mkhairyx/iOS-MoonLamp/README.md

# iOS Moon Lamp
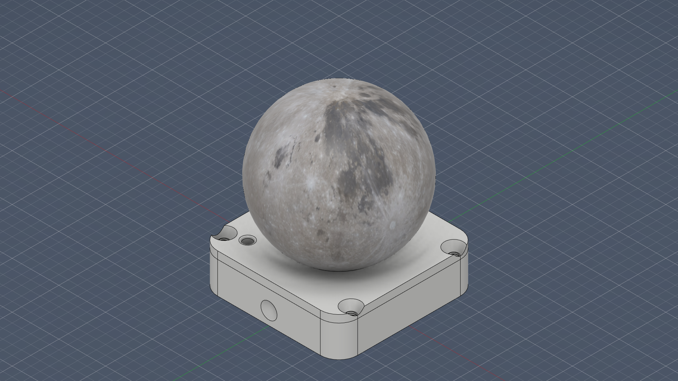
[picture p1: Media/Pictures/Fusion360/iOS_MoonLamp.png]
3D Moon Lamp


Bought a battery powered Moon lamp a few years ago, and it was cool back then but now it’s boring that I have to turn it on and off manually every night. So I removed the insides of it and made it powered with an ESP32 controlled by the iOS Home app.

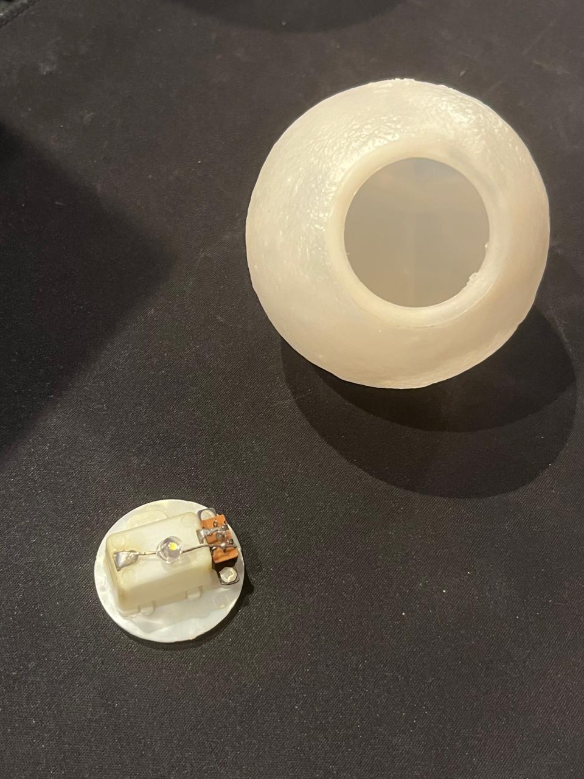
[picture p2: Media/Pictures/Camera/lampbat.jpeg]
Moon Lamp


## The Poster

High resolution poster available [here](./Media/Pictures/PSD/MoonLamp.png).

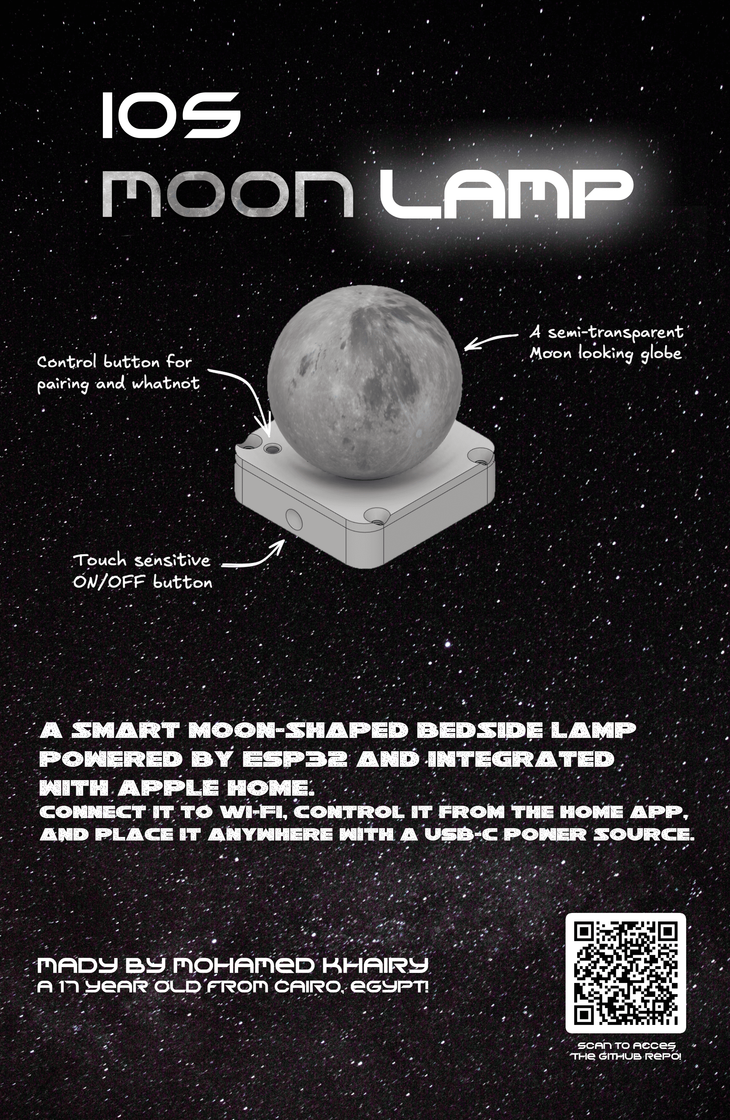
[picture p3: Media/Pictures/PSD/MoonLamp-lores.png]
Poster


## The Design

### The PCB:
Here's how the PCB looks like:
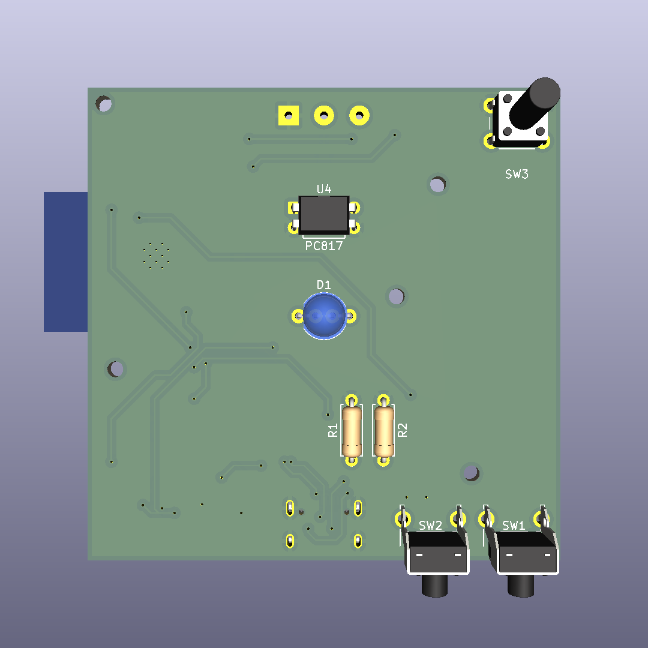
[picture p4: Media/Pictures/KiCad/3D_1-1.png]
3D PCB

And here's the gerber view for it:
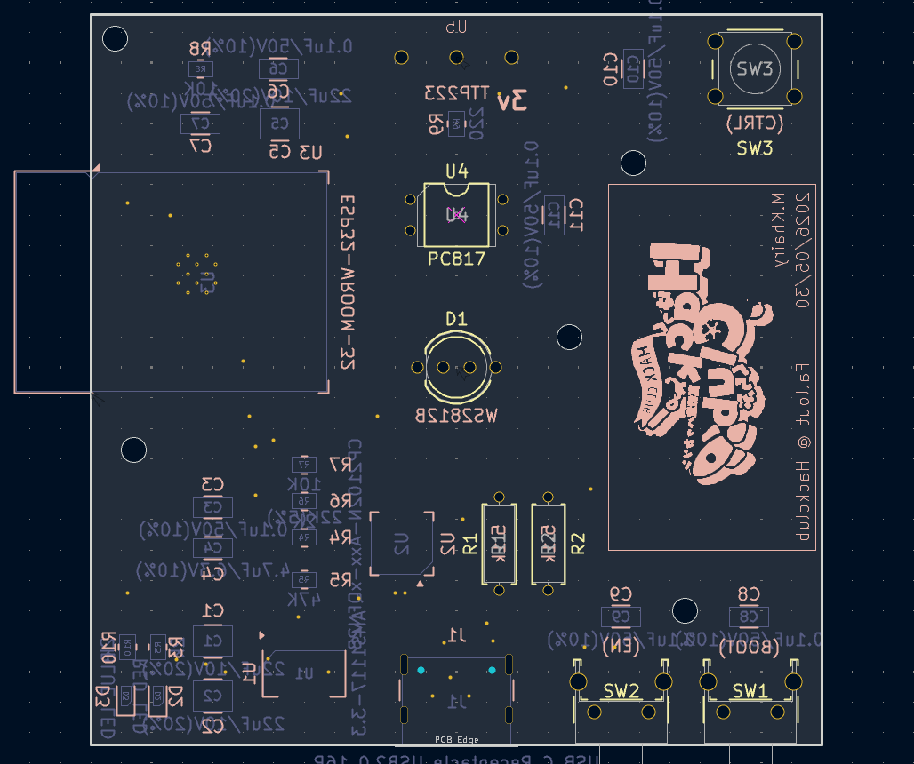
[picture p5: Media/Pictures/KiCad/PCB_Gerber.png]
KiCad PCB


### The Schematics:
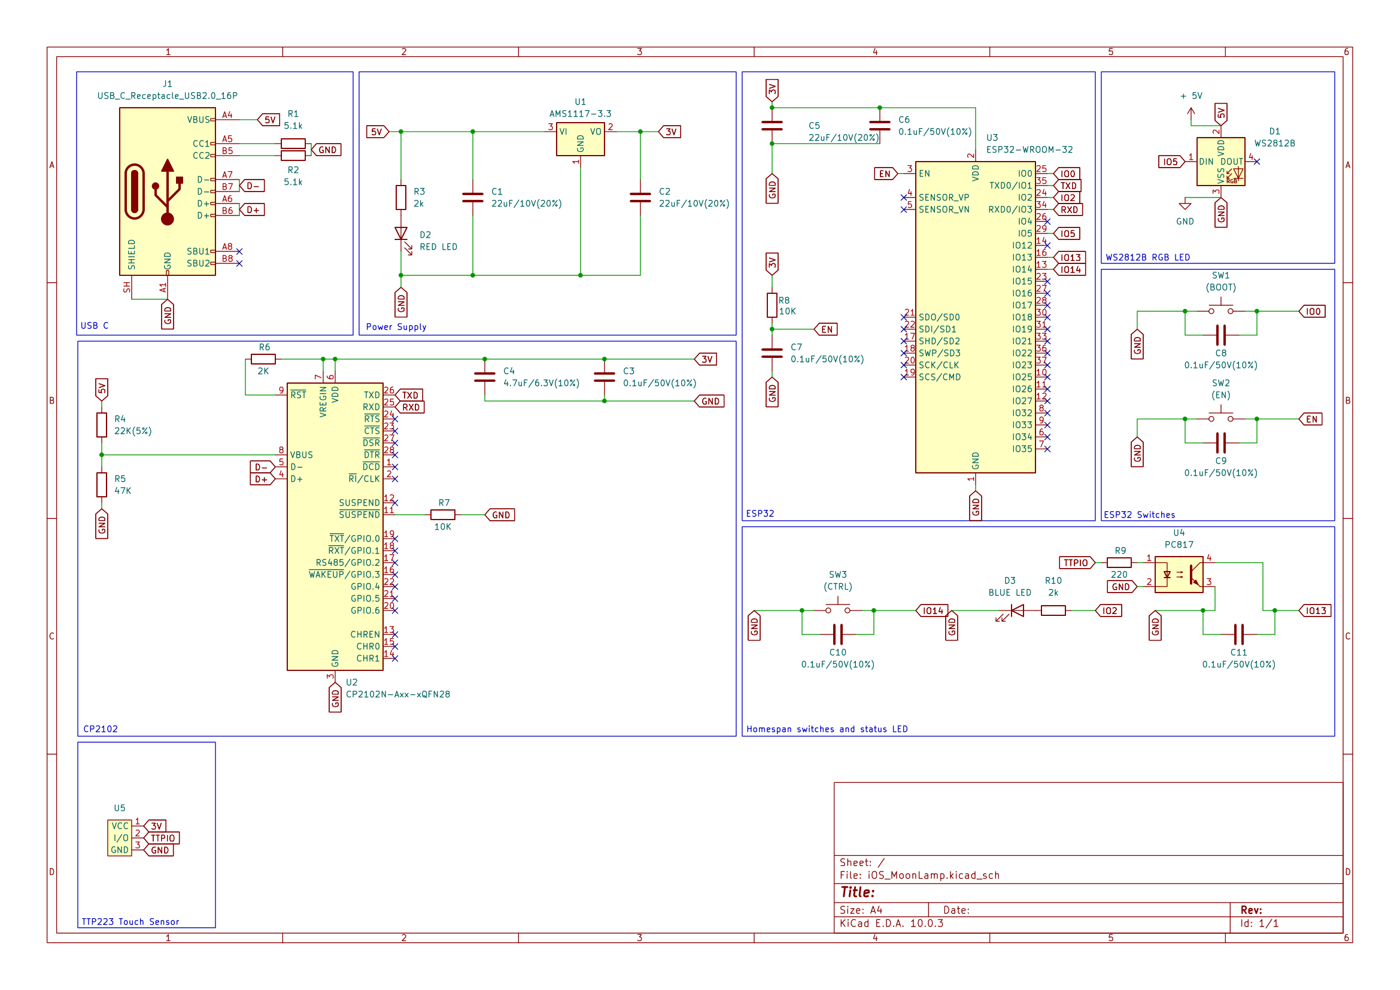
[picture p6: Media/Pictures/KiCad/schematic.png]
Schematic


### The case:
The case is held together with four M5 screws.
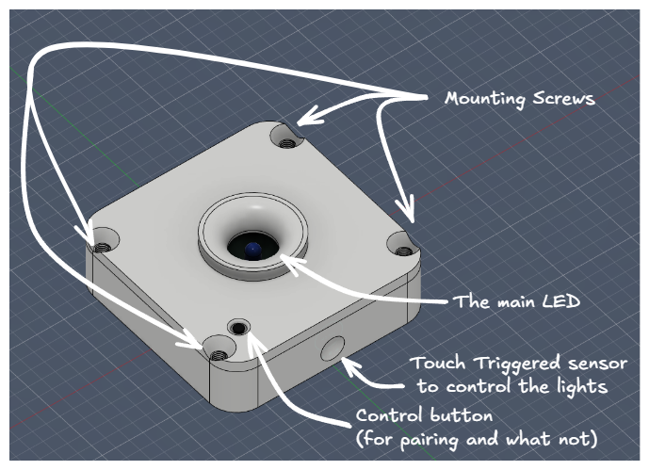
[picture p7: Media/Pictures/Excalidraw/Assemled.png]
Case


## Assembly
### Step Files

Check [Step_Files](./Step_Files/) to see step files.

### Exploded View:
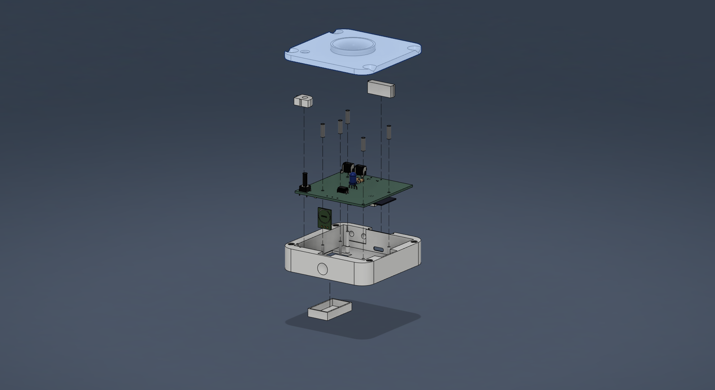
[picture p8: Media/Pictures/Fusion360/Assembly.png]
Exploded


### Assembly video:
This video shows how to assemble and disassemble the case:

https://github.com/user-attachments/assets/3fa87b10-48f1-4240-b7dd-df9781dbfde8

## Firmware
### Compile and flash using the Arduino IDE
If you want to edit the code, compile it yourself, then flash it; you can download the arduino sketch and the required libraries [here](./source/Software/Arduino).
### Flash the firmware as is
If you want to flash the firmware as is, you can download it [here](./source/Software/Firmware). <br>
You can use [ESPWebTool](https://esptool.spacehuhn.com) to flash the firmware directly to the ESP32 using your browser.

## Operating the device
### Power
The device is powered by a USB-C and does not have a battery, so please make sure that it's connected to a stable USB-C power source. 
The device shows wether it's powered on or not through the Red LED on the back near the USB-C port.

### Blue Status LED
The device shows it's status through the Blue Status LED on the back near the USB-C port. 
Refer to [HomeSpan's documentation on HomeSpan Device Status](https://github.com/HomeSpan/HomeSpan/blob/master/docs/UserGuide.md#homespan-device-status) to be able to identify different states.

### CLI
The CLI can be used to setup the device, change the WI-FI credentials, or factory reset the system.[^cli]
You can use the CLI through the onboard USB-C port on the back. Use a baud rate of 9600 for serial communication.

### Control Button
The Control Button can be used to put the device in Command Mode and select different actions.
Refer to [HomeSpan's documentation on Device Command Mode](https://github.com/HomeSpan/HomeSpan/blob/master/docs/UserGuide.md#device-command-mode) to know how to use it

## BOM
Available as a .csv file [here](./BOM/BOM.csv)
### BOM Table (components only)
(Pricing for the enclosure and the PCB will depend on where the stuff are made)
|Name |Value |Link |Cost (EGP) per one|Cost (USD)|Total Cost (EGP)|Total Cost (USD) |Qty |Description |
|---|---|---|---|---|---|---|---|---|
|Capacitor |22uF |https://lampatronics.com/product/smd-multilayer-ceramic-capacitor-1210-22uf-16v-1pcs | EGP 2.00 | $0.038 | EGP 6.00 | $0.12 |3 | |
|Capacitor |100nf |https://lampatronics.com/product/smd-multilayer-ceramic-capacitor-1206-100nf-50v-1pcs | EGP 1.50 | $0.029 | EGP 10.50 | $0.03 |7 | |
|Capacitor |4.7uF |https://lampatronics.com/product/smd-multilayer-ceramic-capacitor-1206-4-7uf-16v-1pcs | EGP 1.50 | $0.029 | EGP 1.50 | $0.03 |1 | |
|Main LED |WS2812B LED |https://uge-one.com/product/f5-5mm-ws2812b-rgb-smart-led-5v/ | EGP 17.10 | $0.329 | EGP 17.10 | $0.33 |1 | |
|Power LED |RED LED |https://lampatronics.com/product/smd-led-0603-red-10pcs | EGP 6.00 | $0.115 | EGP 6.00 | $0.12 |1 | |
|Status LED |BLUE LED |https://lampatronics.com/product/smd-led-0603-blue-10pcs | EGP 6.00 | $0.115 | EGP 6.00 | $0.12 |1 | |
|USB-C |16P |https://www.ram-e-shop.com/shop/usb9-c-type-pcb-usb-connector-on-pcb-c-type-type-female-16-pin-sku-usb9-8125| EGP 5.00 | $0.096 | EGP 5.00 | $0.10 |1 | |
|Resistor |5.1k ohm |https://lampatronics.com/product/resistor-5-1k-ohm-1-4w-2pcs | EGP 0.30 | $0.006 | EGP 0.30 | $0.01 |1 |1 pack of 2 resistors |
|Resistor |2k |https://lampatronics.com/product/smd-resistor-2kohm-202-0805-10pcs | EGP 2.00 | $0.038 | EGP 2.00 | $0.04 |1 |1 pack of 10 resistors|
|Resistor |22k |https://lampatronics.com/product/smd-resistor-22kohm-223-0805-10pcs | EGP 2.00 | $0.038 | EGP 2.00 | $0.04 |1 |1 pack of 10 resistors|
|Resistor |47k |https://lampatronics.com/product/smd-resistor-47k-473-ohm-0805-10pcs | EGP 2.00 | $0.038 | EGP 2.00 | $0.04 |1 |1 pack of 10 resistors|
|Resistor |10k |https://lampatronics.com/product/smd-resistor-10kohm-103-0805-10pcs | EGP 2.00 | $0.038 | EGP 2.00 | $0.04 |1 |1 pack of 10 resistors|
|Resistor |220 |https://lampatronics.com/product/smd-resistor-220ohm-221-0805-10pcs | EGP 2.00 | $0.038 | EGP 2.00 | $0.04 |1 |1 pack of 10 resistors|
|Switch | |https://lampatronics.com/product/push-button-long-right-angle-2pin2base-7x7-5x6mm | EGP 1.50 | $0.029 | EGP 3.00 | $0.03 |2 |Boot and Enable |
|Switch | |https://lampatronics.com/product/push-button-4pin-long-6x6x13mm | EGP 1.50 | $0.029 | EGP 1.50 | $0.03 |1 |Control |
|Voltage Regulator|AMS1117-3.3 |https://lampatronics.com/product/ams1117-adj-sot-223-adj-linear-voltage-regulator | EGP 2.00 | $0.038 | EGP 2.00 | $0.04 |1 | |
|Programmer chip  |CP2102N |https://uge-one.com/product/cp2102-gmr-usb-to-uart-bridge-controller-qfn-28/ | EGP 250.00 | $4.810 | EGP 250.00 | $4.81 |1 | |
|Main MCU |ESP32-WROOM-32|https://uge-one.com/product/espressif-esp32-wroom-32-dual-core-wi-fi-bluetooth-iot-module/ | EGP 290.00 | $5.579 | EGP 290.00 | $5.58 |1 | |
|Optocoupler |PC817 |https://www.ram-e-shop.com/shop/pc817-pc817-el817c-f-5866 | EGP 2.00 | $0.038 | EGP 2.00 | $0.04 |1 | |
|Touch sensor |TTP223 |https://lampatronics.com/product/ttp223-touch-button-module | EGP 10.00 | $0.192 | EGP 10.00 | $0.19 |1 | |
| | | | | | | | | |
| | | | | | EGP 620.90 | $11.74 | | |

### Orders from different manufacturers
#### In Egypt:
[Nori](norisolutions.com) (PCB only): $19.05



[metanoia](metanoia-eg.com) (Case only): $5.77



#### Out of Egypt (international shipping): 
[JLCPCB](https://jlcpcb.com/) (both PCB and Case): $32.42



## Notes
The TTP 223 module is connected to the main PCB using three wires. <br>
The 3D printed case, the PCB, and the Moon itself (the lamp) are not included in the BOM, but their costs are shown in [Orders from different manufacturers](./#Orders-from-different-manufacturers).
The Moon Lamp it self was salvaged from an old lamp, so it costs nothing, therefore it wasn't included in the BOM.

> Made and designed by [@mkhairyx](https://github.com/mkhairyx).<br>
Supported by [Fallout](https://fallout.hackclub.com/) and [Hack Club](https://hackclub.com).<br>
Powered by [HomeSpan](https://github.com/HomeSpan/HomeSpan)<br>
<hr>

[^cli]: Check the [The HomeSpan Command-Line Interface (CLI)](https://github.com/HomeSpan/HomeSpan/blob/master/docs/CLI.md) to be able to use the device's CLI through the onboard USB-C port.
