mkhairyx/iOS-MoonLamp/zine.pdf

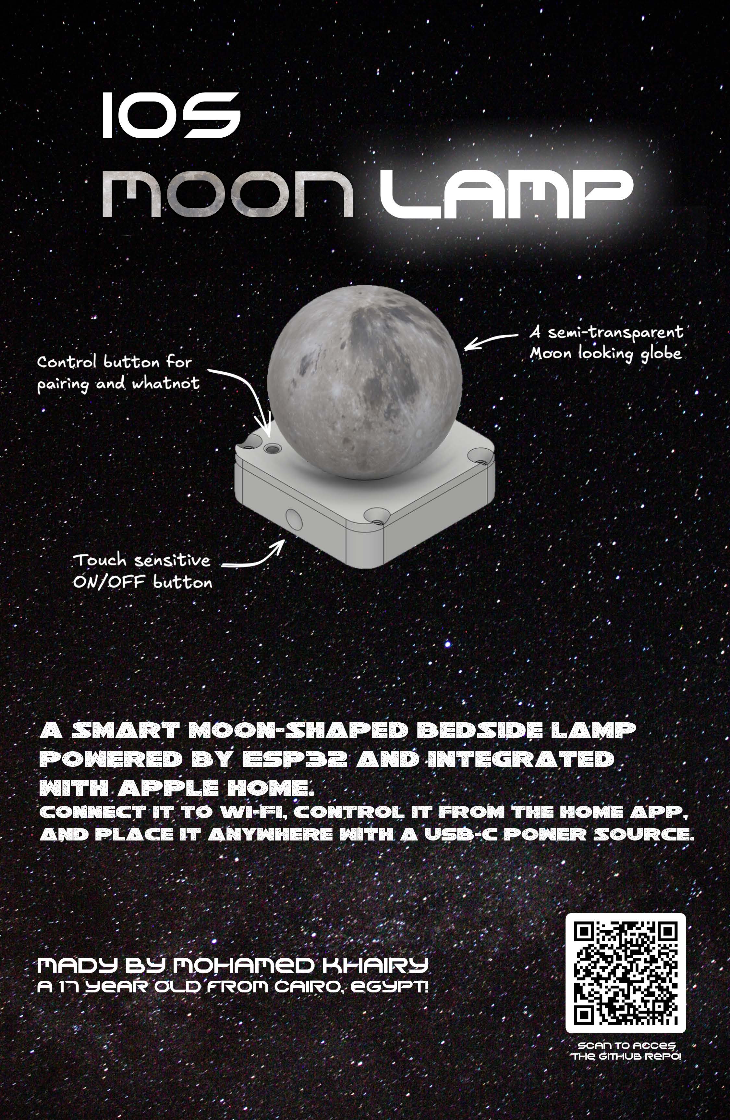
[picture p9: page 1]
