mkhairyx/iOS-MoonLamp/Media/Pictures/Excalidraw/ButtonCover.png

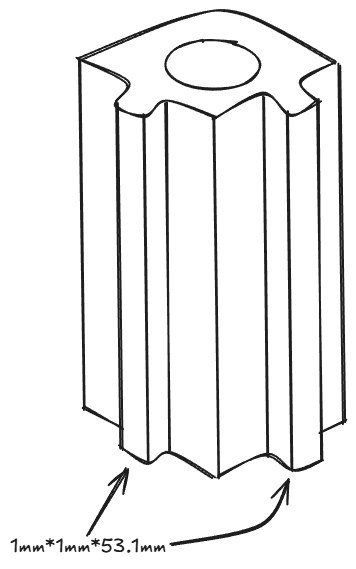
Media/Pictures/Excalidraw/ButtonCover.png
