mkhairyx/iOS-MoonLamp/Media/Pictures/Excalidraw/diagram.png

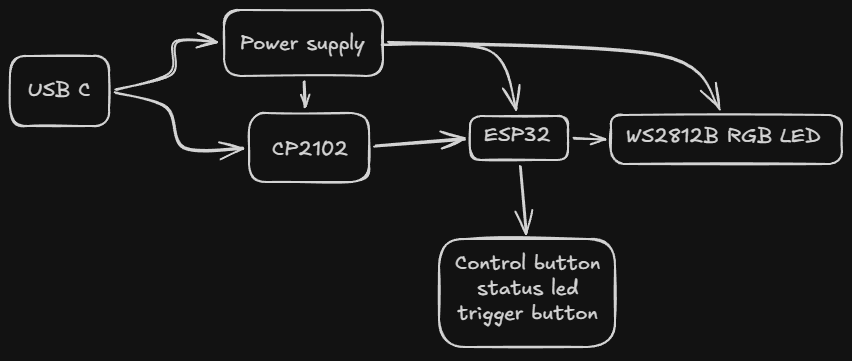
Media/Pictures/Excalidraw/diagram.png
