mkhairyx/iOS-MoonLamp/Media/Pictures/Excalidraw/toprint.png

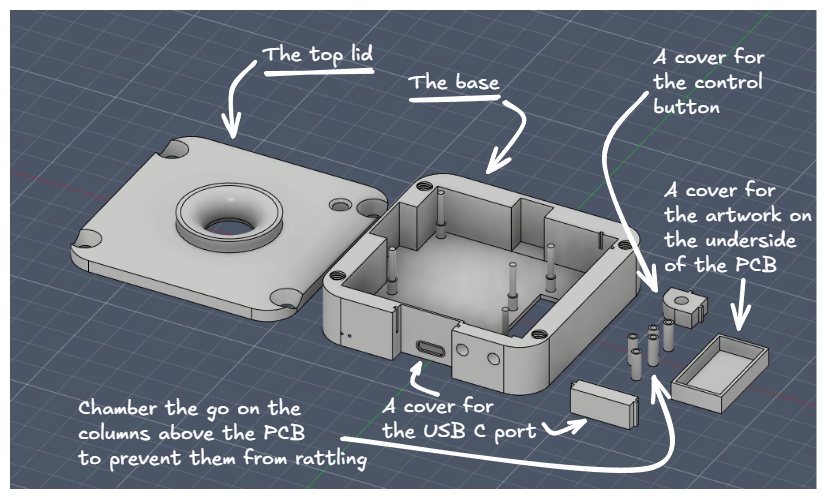
Media/Pictures/Excalidraw/toprint.png
