mkhairyx/iOS-MoonLamp/Media/Pictures/Fusion360/3D_PCB_1.png

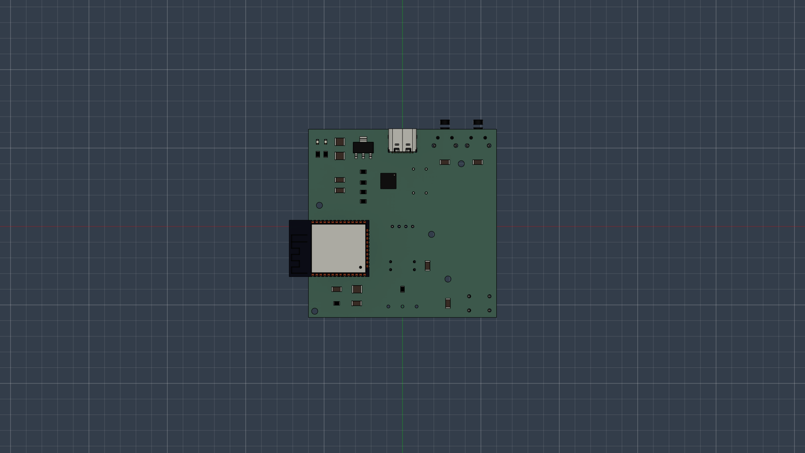
Media/Pictures/Fusion360/3D_PCB_1.png
