mkhairyx/iOS-MoonLamp/Media/Pictures/Fusion360/iOS_MoonLamp_BG.png

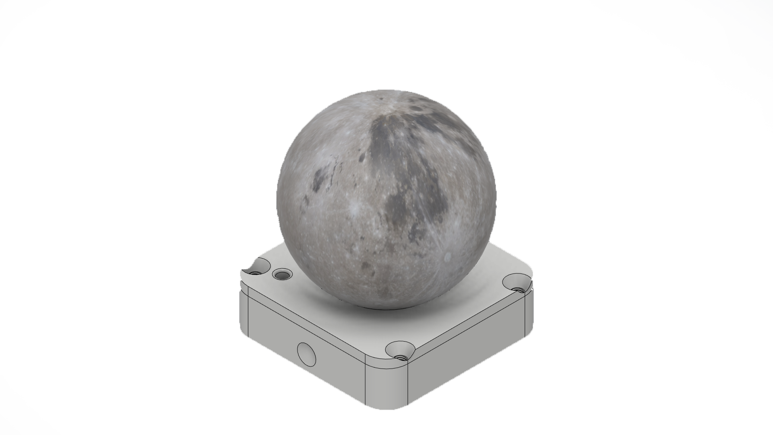
Media/Pictures/Fusion360/iOS_MoonLamp_BG.png
