mkhairyx/iOS-MoonLamp/Media/Pictures/KiCad/3D_16-9.png

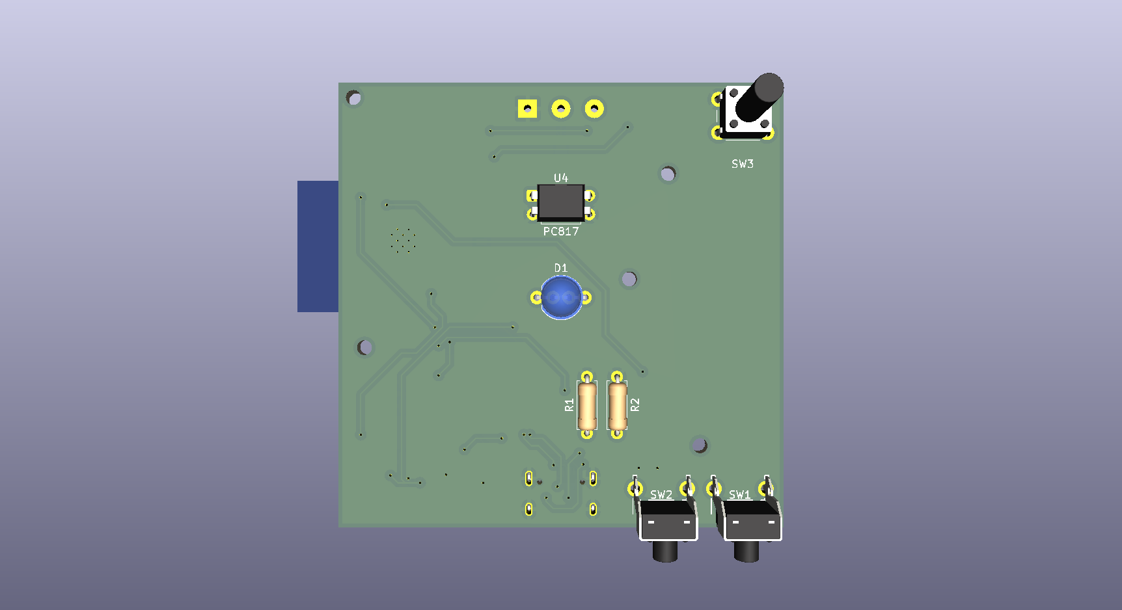
Media/Pictures/KiCad/3D_16-9.png
