mkhairyx/iOS-MoonLamp/Step_Files/Assembled_case/Assembled_case.step

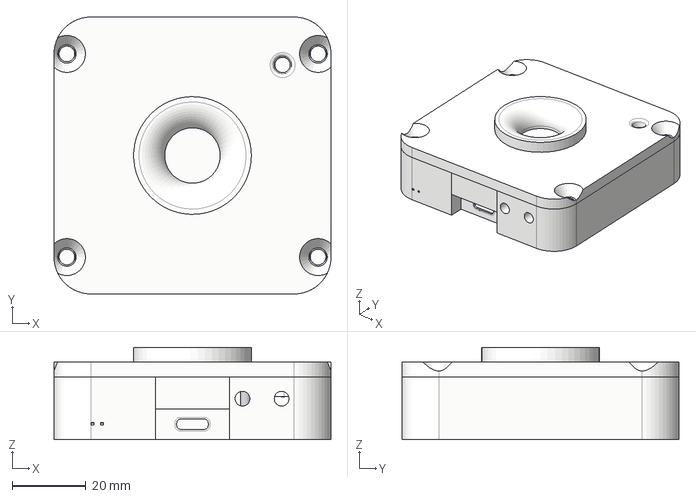
[picture p16: CAD file, 2026-06-11]
Step_Files/Assembled_case/Assembled_case.step
75.0 x 75.0 x 25.0 mm
