mkhairyx/iOS-MoonLamp/source/Fusion 360 - 3D/Case.step

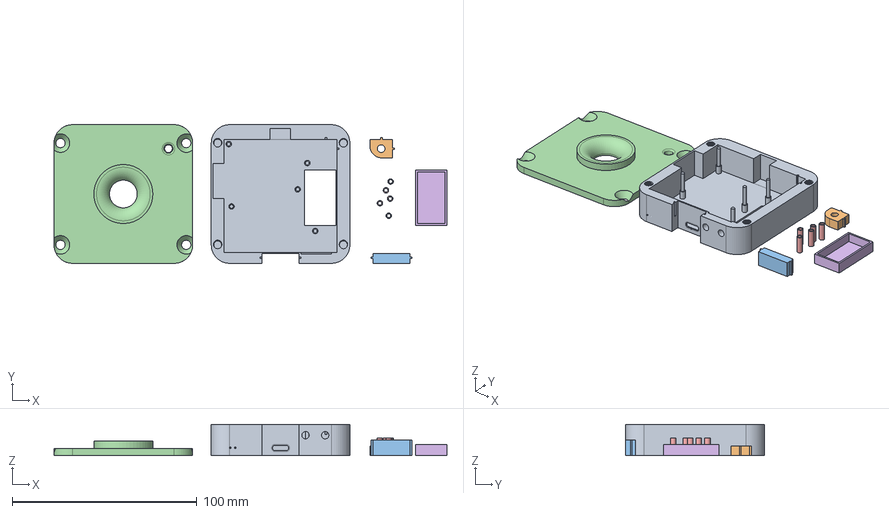
[picture p17: CAD file, 2026-06-04]
source/Fusion 360 - 3D/Case.step
212.5 x 75.0 x 17.0 mm
