mkhairyx/iOS-MoonLamp/source/KiCad - PCB/iOS_MoonLamp/MoonLamp_PCB.step

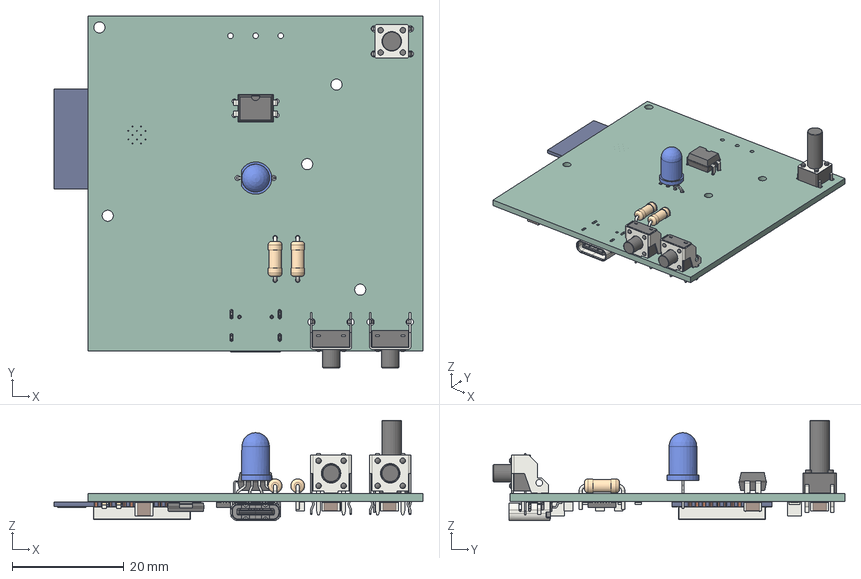
[picture p18: CAD file, 2026-06-04]
source/KiCad - PCB/iOS_MoonLamp/MoonLamp_PCB.step
66.1 x 63.0 x 18.0 mm
R_Axial_DIN0207_L63mm_D25mm_P762mm_Horizontal x 2
LED_D5.0mm-4_RGB_Wide_Pins
SW_PUSH_6mm_h13mm
SW_Tactile_SPST_Angled_PTS645Vx58-2LFS x 2
DIP-4_W7.62mm
C_1206_3216Metric x 8
R_0805_2012Metric x 8
SOT-223
QFN-28-1EP_5x5mm_Pitch0.5mm
LED_0603_1608Metric x 2
C_1210_3225Metric x 3
USB_C_Receptacle_16P_TopMnt_Horizontal_GCT_USB4105-xx-A
ESP32-WROOM-32
iOS_MoonLamp_PCB
