mkhairyx/iOS-MoonLamp/(list of files, cad)

Other CAD files:
Step_Files/Case/Case.step
source/Fusion 360 - 3D/Case.f3d
