mkhairyx/iOS-MoonLamp/Step_Files/Assembled_case/Assembled_case.png

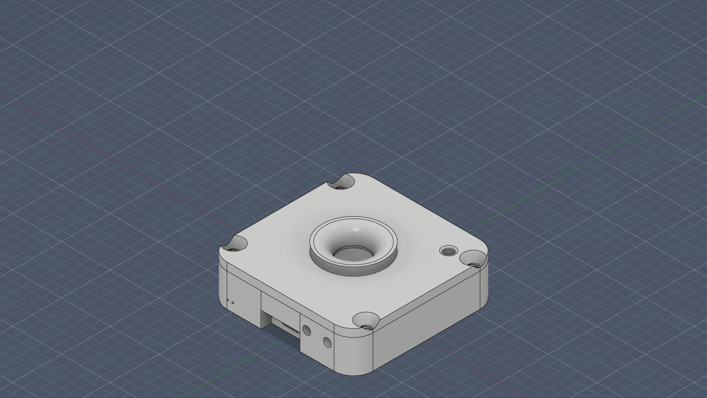
Step_Files/Assembled_case/Assembled_case.png
