mkhairyx/iOS-MoonLamp/Step_Files/Case/Case.png

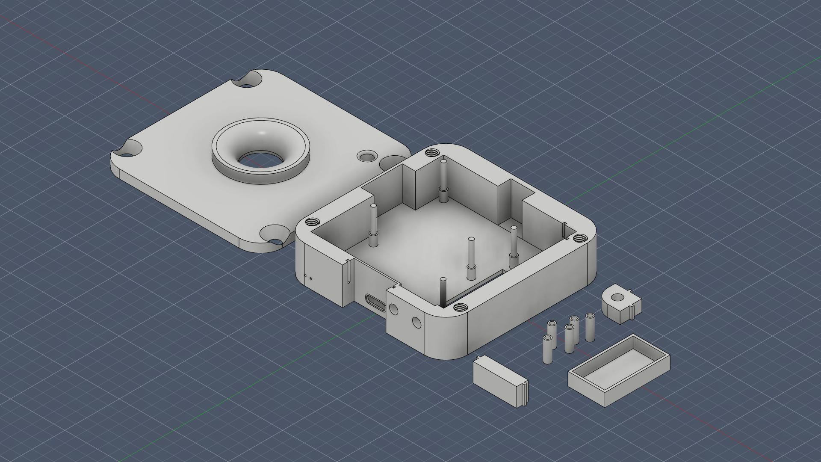
Step_Files/Case/Case.png
