mkhairyx/iOS-MoonLamp/Step_Files/Device/Device.png

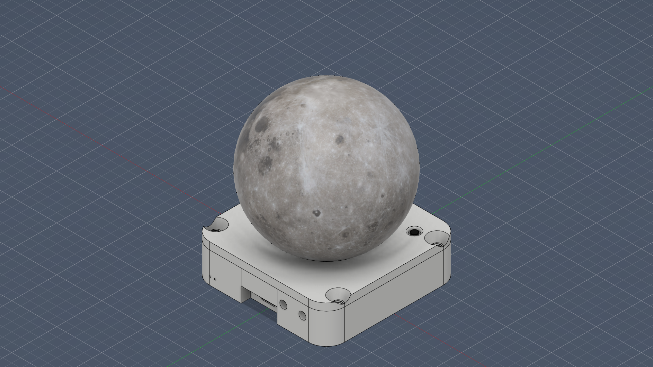
Step_Files/Device/Device.png
