mkhairyx/iOS-MoonLamp/source/KiCad - PCB/iOS_MoonLamp/iOS_MoonLamp.kicad_pcb

## KiCad design source/KiCad - PCB/iOS_MoonLamp/iOS_MoonLamp.kicad_pcb (2026-06-11)

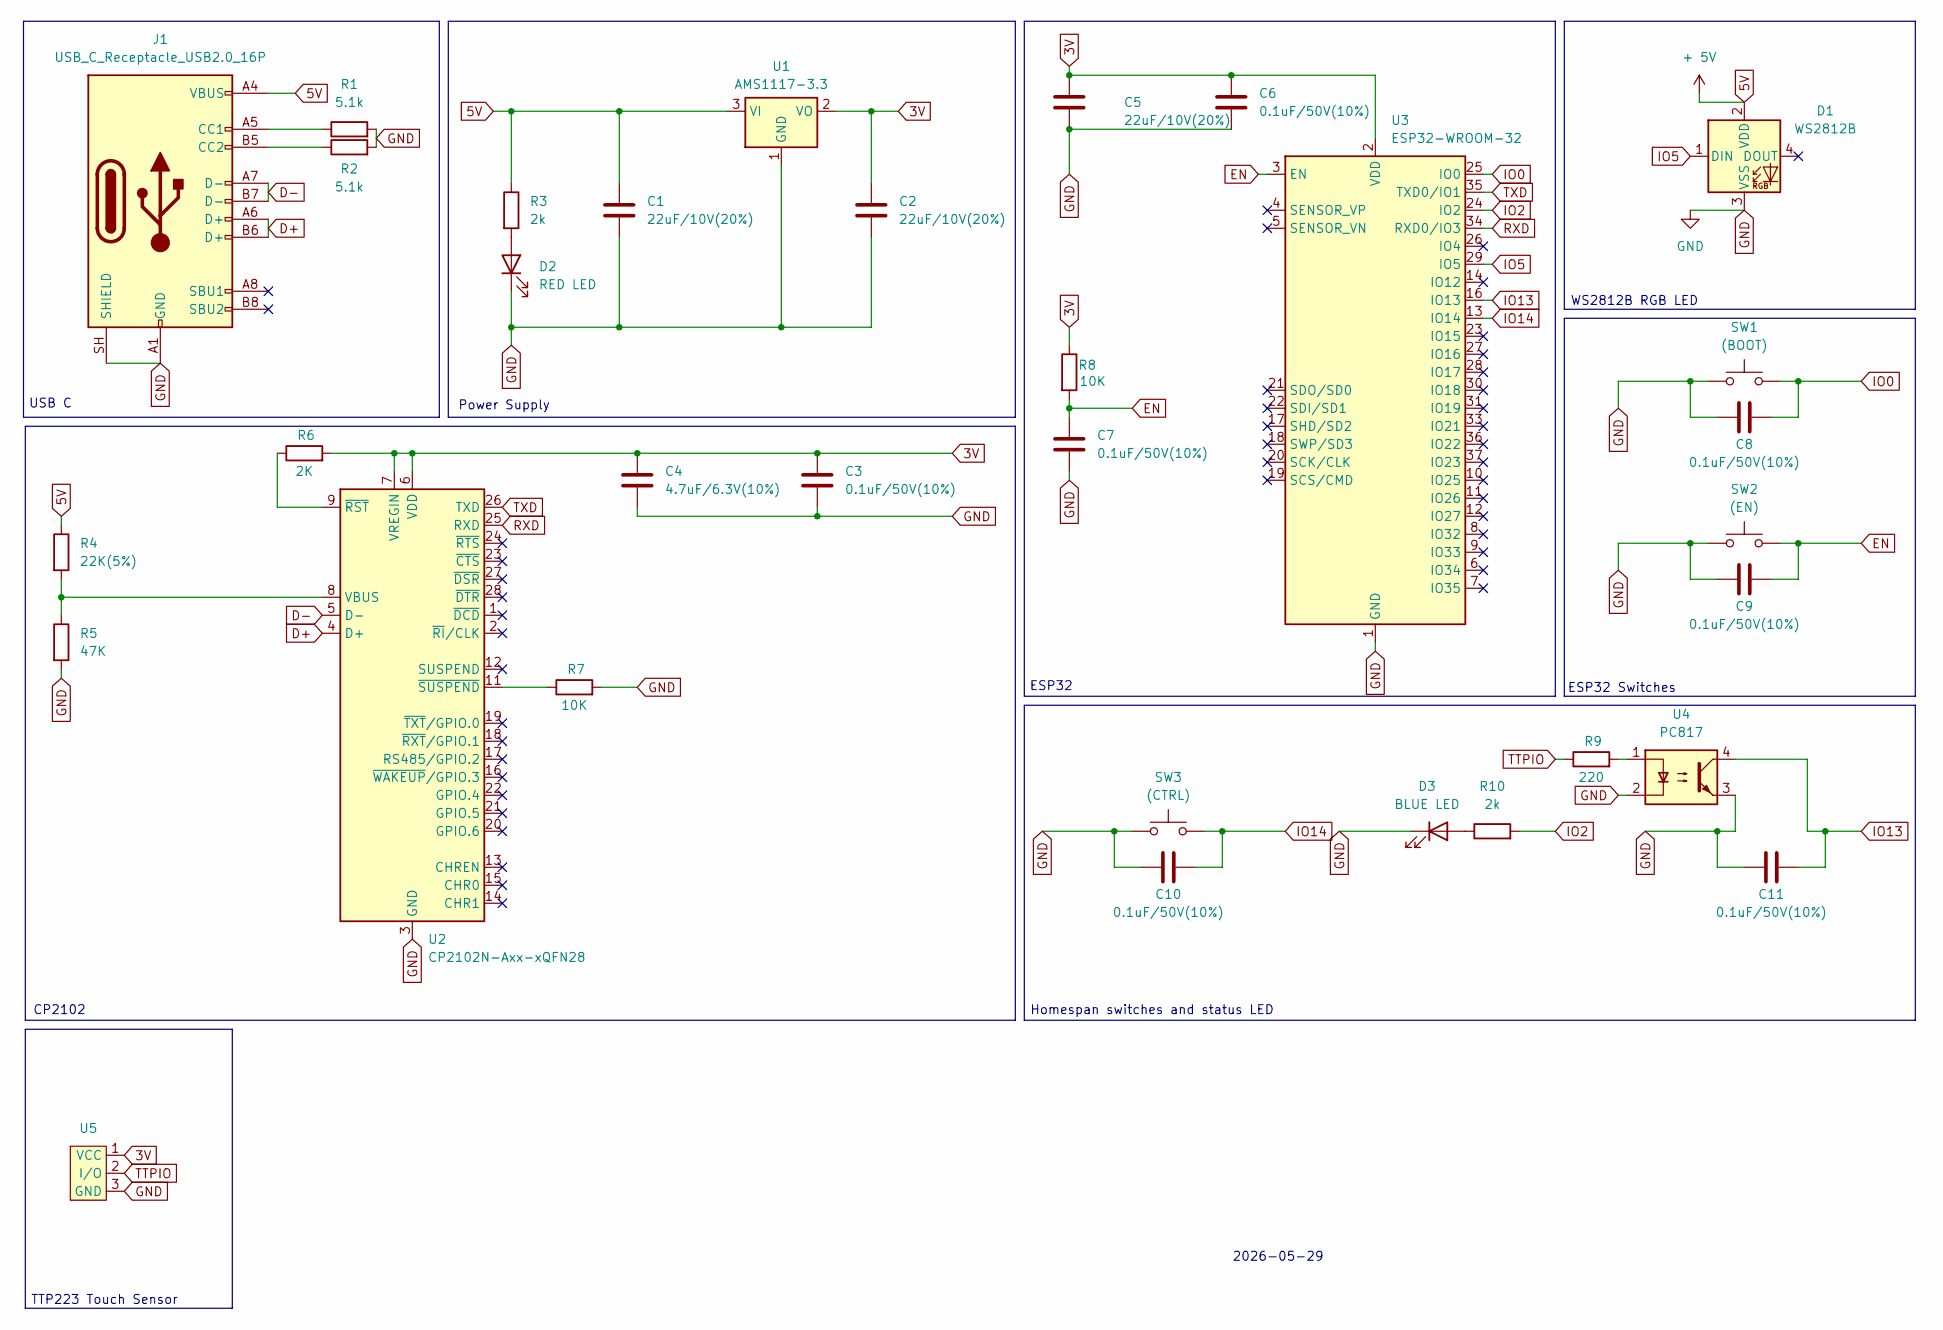
[picture p22: schematic iOS_MoonLamp.kicad_sch]

Parts:
C1, C2, C5: 22uF/10V(20%); C_1210_3225Metric_Pad1.33x2.70mm_HandSolder
C3, C6, C7, C8, C9, C10, C11: 0.1uF/50V(10%); C_1206_3216Metric_Pad1.33x1.80mm_HandSolder
C4: 4.7uF/6.3V(10%); C_1206_3216Metric_Pad1.33x1.80mm_HandSolder
D1: WS2812B; LED_D5.0mm-4_RGB_Wide_Pins
D2: RED LED; LED_0603_1608Metric_Pad1.05x0.95mm_HandSolder
D3: BLUE LED; LED_0603_1608Metric_Pad1.05x0.95mm_HandSolder
J1: USB_C_Receptacle_USB2.0_16P; USB_C_Receptacle_GCT_USB4105-xx-A_16P_TopMnt_Horizontal
R1, R2: 5.1k; R_Axial_DIN0207_L6.3mm_D2.5mm_P7.62mm_Horizontal
R3, R10: 2k; R_0805_2012Metric_Pad1.20x1.40mm_HandSolder
R4: 22K(5%); R_0805_2012Metric_Pad1.20x1.40mm_HandSolder
R5: 47K; R_0805_2012Metric_Pad1.20x1.40mm_HandSolder
R6: 2K; R_0805_2012Metric_Pad1.20x1.40mm_HandSolder
R7, R8: 10K; R_0805_2012Metric_Pad1.20x1.40mm_HandSolder
R9: 220; R_0805_2012Metric_Pad1.20x1.40mm_HandSolder
SW1: (BOOT); SW_Tactile_SPST_Angled_PTS645Vx58-2LFS
SW2: (EN); SW_Tactile_SPST_Angled_PTS645Vx58-2LFS
SW3: (CTRL); SW_PUSH_6mm_H13mm
U1: AMS1117-3.3; SOT-223-3_TabPin2
U2: CP2102N-Axx-xQFN28; QFN-28-1EP_5x5mm_P0.5mm_EP3.35x3.35mm
U3: ESP32-WROOM-32
U4: PC817; DIP-4_W7.62mm
U5: Untitled

Connections:
3V: C2.1, C3.1, C4.1, C5.1, C6.1, R6.2, R8.1, U1.2 (VO), U2.6 (VDD), U2.7 (VREGIN), U3.2 (VDD), U5.1 (VCC)
5V: C1.1, D1.2 (VDD), J1.A4 (VBUS), J1.A9 (VBUS), J1.B4 (VBUS), J1.B9 (VBUS), R3.1, R4.1, U1.3 (VI)
D+: J1.A6 (D+), J1.B6 (D+), U2.4 (D+)
D-: J1.A7 (D-), J1.B7 (D-), U2.5 (D-)
EN: C7.1, C9.2, R8.2, SW2.2, U3.3 (EN)
GND: C1.2, C2.2, C3.2, C4.2, C5.2, C6.2, C7.2, C8.1, C9.1, C10.1, C11.1, D1.3 (VSS), D2.1 (K), D3.1 (K), J1.A1 (GND), J1.A12 (GND), J1.B1 (GND), J1.B12 (GND), J1.SH (SHIELD), R1.2, R2.2, R5.2, R7.2, SW1.1, SW2.1, SW3.1, U1.1 (GND), U2.3 (GND), U2.29 (GND), U3.1 (GND), U3.15 (GND), U3.38 (GND), U3.39 (GND), U4.2, U4.3, U5.3 (GND)
IO0: C8.2, SW1.2, U3.25 (IO0)
IO2: R10.2, U3.24 (IO2)
IO5: D1.1 (DIN), U3.29 (IO5)
IO13: C11.2, U3.16 (IO13), U4.4
IO14: C10.2, SW3.2, U3.13 (IO14)
unnamed: D2.2 (A), R3.2
unnamed: D3.2 (A), R10.1
unnamed: J1.A5 (CC1), R1.1
unnamed: J1.B5 (CC2), R2.1
unnamed: R9.2, U4.1
unnamed: R4.2, R5.1, U2.8 (VBUS)
unnamed: R6.1, U2.9 (~RST)
unnamed: R7.1, U2.11 (~SUSPEND)
RXD: U2.25 (RXD), U3.34 (RXD0/IO3)
TTPIO: R9.1, U5.2 (I/O)
TXD: U2.26 (TXD), U3.35 (TXD0/IO1)

Notes on the sheet:
Power Supply
TTP223 Touch Sensor
ESP32 Switches
USB C
CP2102
ESP32
Homespan switches and status LED
2026-05-29
WS2812B RGB LED

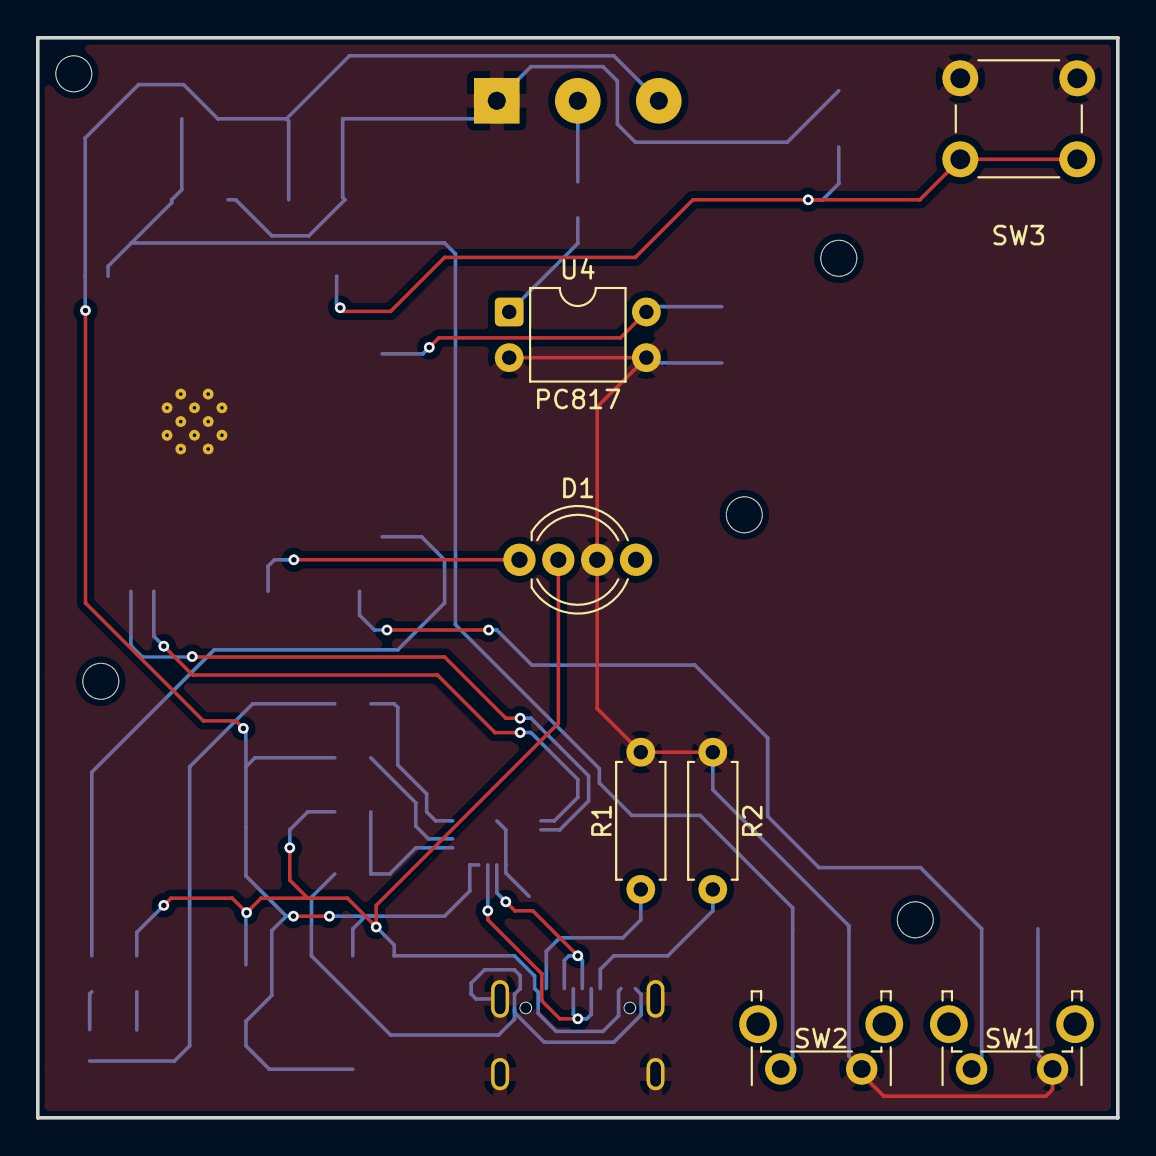
[picture p23: board iOS_MoonLamp.kicad_pcb from above]

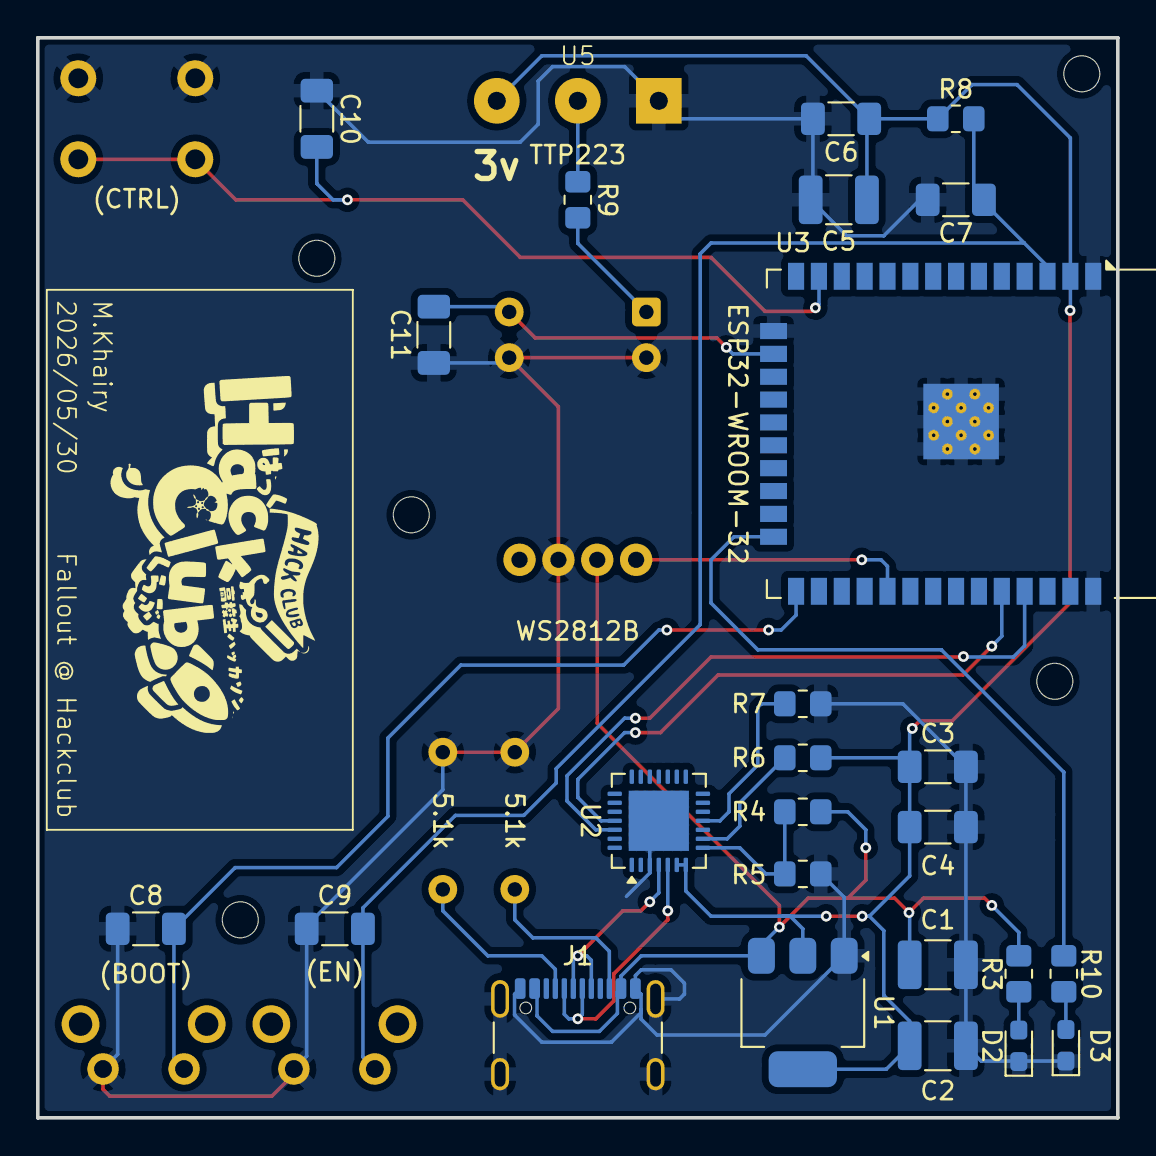
[picture p24: board iOS_MoonLamp.kicad_pcb from below]

Board: 2 copper layers, 60.0 x 60.0 mm, 33 parts (26 on the bottom side), 22 nets.
