mkhairyx/iOS-MoonLamp/(commit log)

2026-06-04 adding bom
    [BOM.csv]
2026-06-04 adding kicad source files
    [MoonLamp_PCB.step, freerouting.dsn, iOS_MoonLamp.kicad_pcb, iOS_MoonLamp.kicad_sch, temp-freerouting.dsn]
2026-06-04 adding source fusion 3d files
    [Case.f3d, Case.step]
2026-06-04 uploading software
    [partitions.csv]
2026-06-04 Adding camera folder and camera pic for the Moon Lamp.
2026-06-04 mp4 version of the assembly video
2026-06-04 Create README.md for iOS Moon Lamp project
    Added detailed project information, including design, assembly instructions, and bill of materials.
2026-06-04 Update README with operating instructions for the device
    Added sections on device operation, including power, status LED, CLI, and control button usage.
2026-06-05 Update README with case assembly details
2026-06-08 Added production files
    [iOS-MoonLamp_bom.csv, iOS-MoonLamp_designators.csv, iOS-MoonLamp_positions.csv, iOS_MoonLamp.kicad_pcb_bom.csv, iOS_MoonLamp.kicad_pcb_positions.csv]
2026-06-08 Enhance README with BOM and manufacturer order details
    Added BOM table and orders from different manufacturers sections to README.
2026-06-08 Added costs for the case through metanoia
2026-06-11 Deleted autorouting files (note to reviewers: I attempted auto routing and failed at it. I routed everything manual but forgot to continue recording. I'll be rerouting everything manually and record 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
    [freerouting.dsn, temp-freerouting.dsn]
2026-06-11 Rerouted the PCB
    [iOS_MoonLamp.kicad_pcb]
2026-06-11 Added a Prices in usd column for the BOM
    [BOM.csv]
2026-06-11 Clean up BOM.csv by removing empty lines
    Removed empty lines and adjusted total row formatting.
    [BOM.csv]
2026-06-11 Remove empty line in BOM.csv
    Removed empty line from BOM.csv.
    [BOM.csv]
2026-06-11 edited BOM to have total cost per component
    [BOM.csv]
2026-06-11 Fix BOM.csv
    [BOM.csv]
2026-06-11 fix BOM
    [BOM.csv]
2026-06-11 fixed prices
    [BOM.csv]
2026-06-11 fix prices
    [BOM.csv]
2026-06-11 Revise BOM table with pricing details and notes
    Updated BOM table to include pricing per unit and total cost for components. Added notes regarding pricing for enclosure and PCB manufacturing.
2026-06-11 Added step files
    [Assembled_case.step, Case.step]
2026-06-11 Add step files section to README
    Added a section for step files in the assembly instructions.
2026-06-11 Fixed BOM
    [BOM.csv]
2026-06-11 Clean up BOM.csv by removing empty rows
    Removed empty rows from BOM.csv to clean up the data.
    [BOM.csv]
2026-06-11 Revise BOM table with total cost calculations
    Updated BOM table to include total costs and improved formatting.
